esrijan/ddk-hardware/ddk-Back.pdf

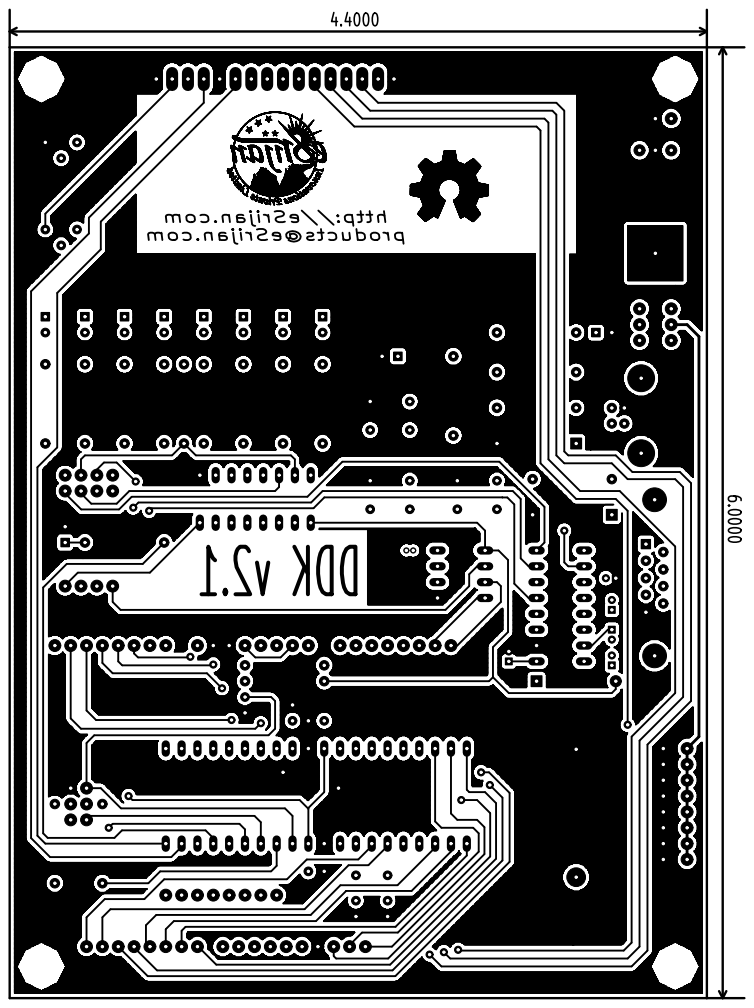
[picture p1: page 1]
