esrijan/ddk-hardware/ddk-drl.pdf

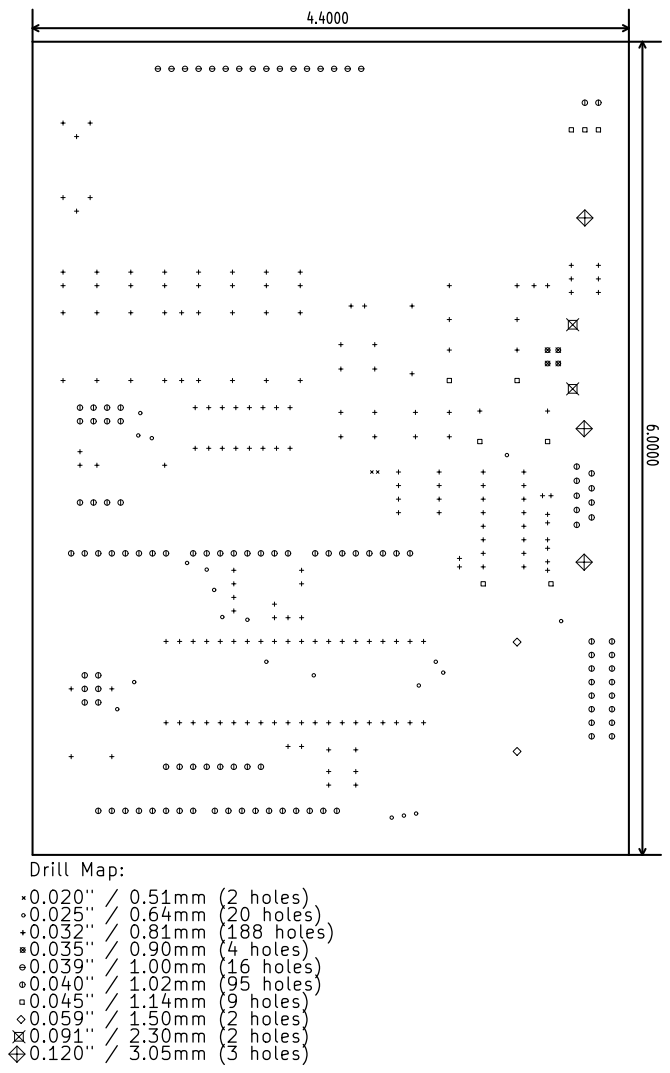
[picture p2: page 1]
