esrijan/ddk-hardware/ddk-Front.pdf

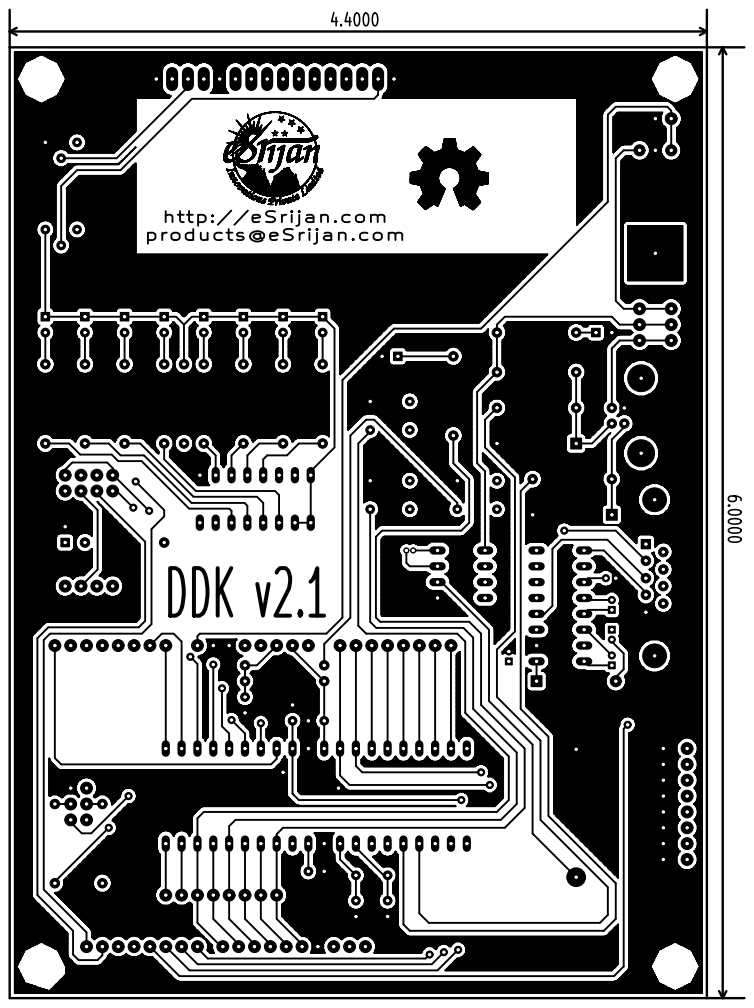
[picture p3: page 1]
