esrijan/ddk-hardware/ddk-Mask_Back.pdf

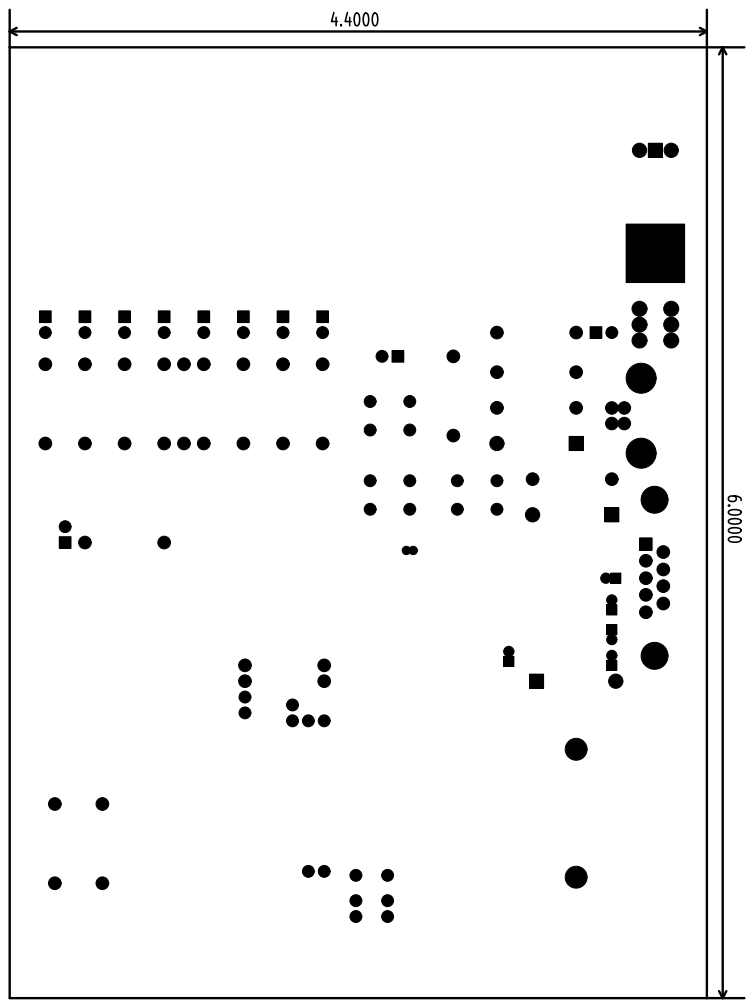
[picture p4: page 1]
