esrijan/ddk-hardware/ddk-Mask_Front.pdf

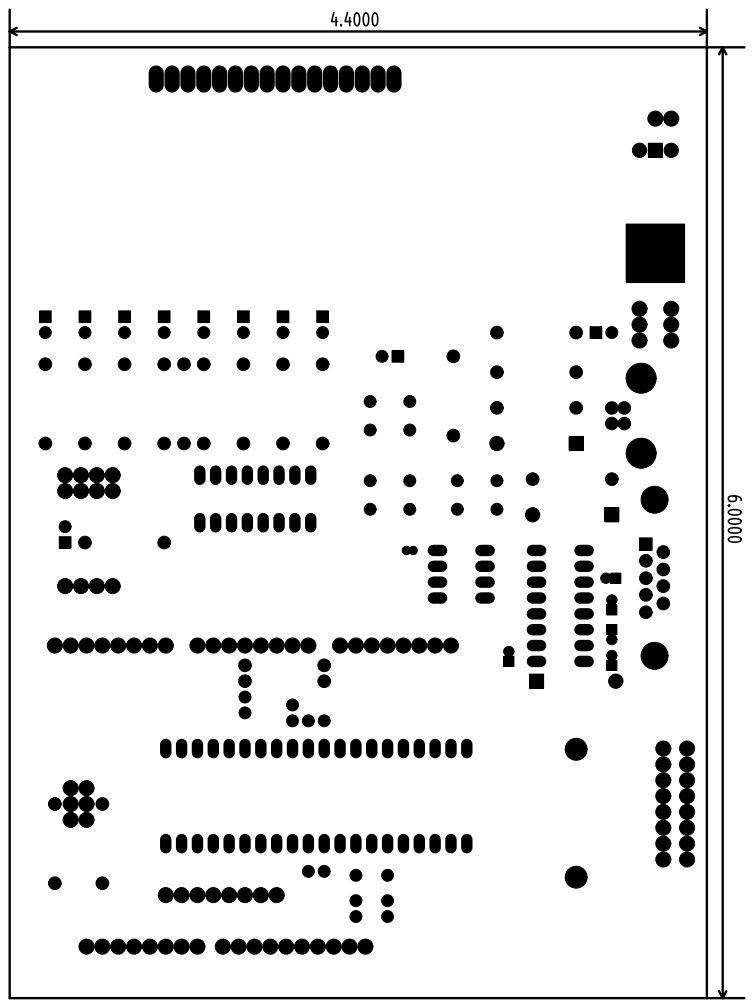
[picture p5: page 1]
