esrijan/ddk-hardware/ddk-SilkS_Back.pdf

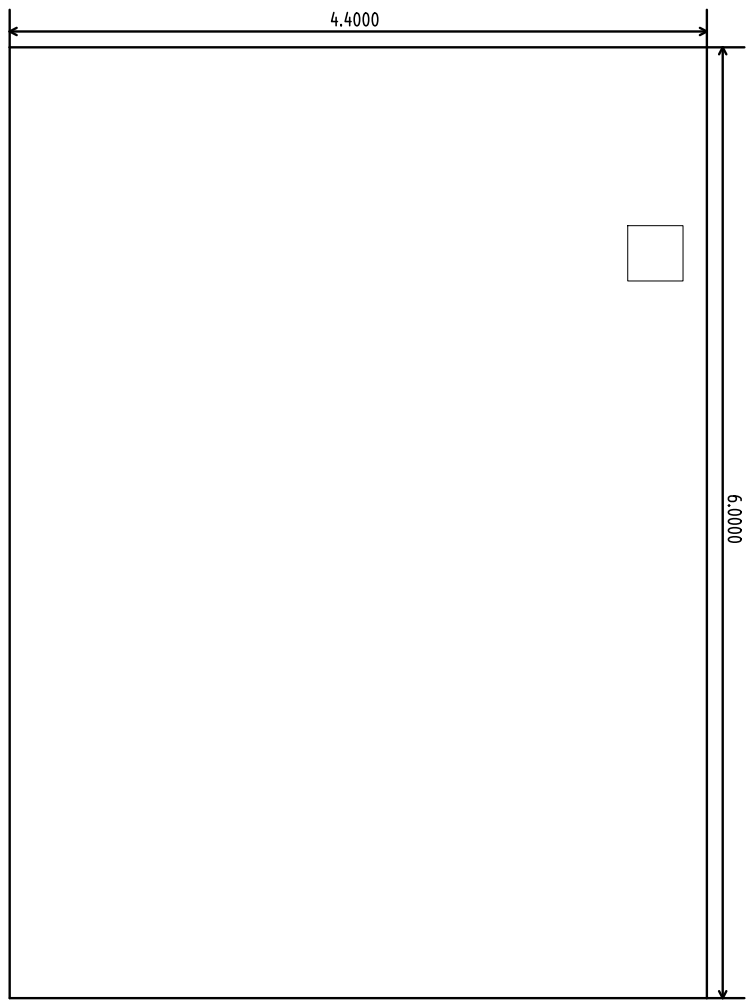
[picture p6: page 1]
