esrijan/ddk-hardware/ddk-SilkS_Front.pdf

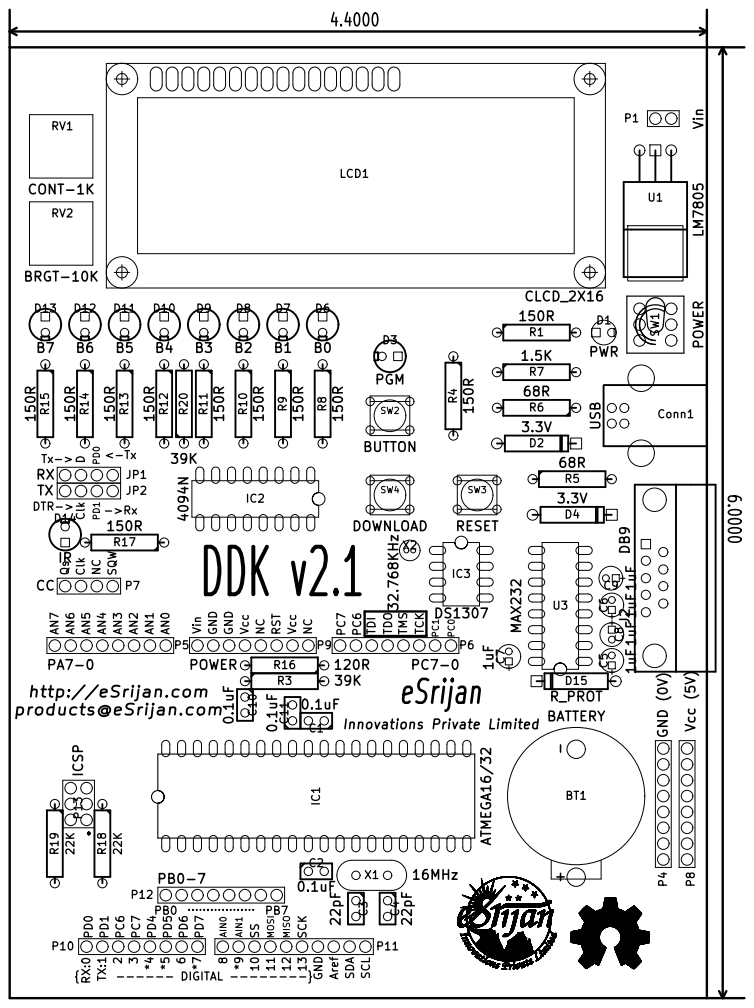
[picture p7: page 1]
