esrijan/ddk-hardware/ddk.sch

## KiCad design ddk.sch (2013-03-20, an earlier design)

Schematic: ddk.sch

Parts:
BT1: BATTERY
C1, C2, C10, C11: 0.1uF; C1
C3, C4: 22pF; C1
C5, C6, C7, C8, C9: 1uF; C1/16
Conn1: USB; CONN_USB-B
D1: PWR; LED3
D2, D4: 3.3V; D5
D3: PGM; LEDV
D6: B0; LEDV
D7: B1; LEDV
D8: B2; LEDV
D9: B3; LEDV
D10: B4; LEDV
D11: B5; LEDV
D12: B6; LEDV
D13: B7; LEDV
D14: IR; LEDV
D15: G_PROT; D5
IC1: ATMEGA16/32; atmel-DIL40
IC2: 4094N; 40xx-DIL16
IC3: DS1307; dallas-SOIC-8
J2: DB9; DB9FC
JP1: RX; header-4
JP2: TX; header-4
LCD1: CLCD 2X16; lcd_2x16_led_backlight-HY-1602F
P1: Vin; header-2
P4: GND (0V); header-8
P5: PA7-0; header-8
P6: PC7-0; header-8
P7: CC
P8: Vcc (5V); header-8
P9: POWER; header-8
P10: DIGITAL; header-8
P11: DIGITAL 2; header-10
P12: PB0-7; header-8
P13: ICSP; header-3x2
R1, R4, R8, R9, R10, R11, R12, R13, R14, R15, R17: 150R; R5
R3: 39K; R5
R5, R6: 68R; R5
R7: 1.5K; R5
R16: 120R; R5
R18, R19: 22K; R5
RV1: CONT-1K; pot_sq
RV2: BRGT-10K; pot_sq
SW1: POWER
SW2: BUTTON; sw_push_s
SW3: RESET; sw_push_s
SW4: DOWNLOAD; sw_push_s
U1: LM7805; LM78XX
U3: MAX232; max232ti-DIL16
X1: 16MHz; Cr2
X2: 32.768KHz; CrClk
