esrijan/ddk-hardware/(commit log)

2012-12-21 Readying the DDK hardware design v1.1 for upload to shareable git.
    [usb_driver_kit.brd, usb_driver_kit.sch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]
2013-02-13 DDK v2.0 related checkin
    + Renamed usb_driver_kit to ddk
    + Corrected the description swap between .cmp & .stf files in the README.md
    + Final schematic (w/ old annotations preserved)
    + Final footprint associations (w/ old annotations preserved)
    + Board layout & related stuff are still the old ones
    [ddk.brd, ddk.sch, usb_driver_kit.sch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]
2013-02-14 DDK v2.0 related checkin #2
    + Final board layout done (for the schematic & footprint associations, already checked-in)
    > Alongwith, placed eSrijan & OSHW's logos as modules in board's copper & silkscreen layers
    > So, adding the corresponding module related files, as well
    + Consequently, plotted the same in .ps format & then converted to .pdf format (using ps2pdf)
    > Front, Back, Mask_Front, Mask_Back, SilkS_Front, SilkS_Back
    > Alongwith generated the drill file as well
    + As the plot file names have changed, deleted the earlier boards' (DDK v1.*) .ps & .pdf files
    [ddk.drl]
2013-02-15 DDK v2.0 related checkin #3
    + Updates in the final board layout before fabrication, as per the inputs from the fabricator
    > All vias' (pad) increased - at least 0.045" as in DDK v1.*
    . Triggered a complete recheck & via-track distance fixes in the board
    > Corrected 3mm LED's pad & drill sizes to same as for the normal 5mm LED (it was too small)
    . Got changes generated through module editor but then manually edited in leds module and ddk.brd
    > Increased the clock crystal's pads size a bit (it was too small & would still remain small)
    . Got changes generated through module editor but then manually edited in crystals module and ddk.brd
    > All headers' drill size to be 1mm
    . Got chang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
    [ddk.csv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]
2013-03-20 DDK v2.1 related checkin #2
    Where is the DDK v2.1 related checkin #1? Actually, the previous one
    commit referred as DDK v2.0 checkin #3, is in fact the DDK v2.1 related
    checkin #1. And this checkin is the final checkin, as sent for
    fabrication of DDK v2.1. It contains the following changes from v2.0:
    + Schematic:
    > Pulled-up the D of shift resister to get fixed default off state
    of the LED array
    > Renamed the G(ermanium) Prot(ection) to R(everse) Protection, as
    the normal diode seems more promising than the germanium diode,
    at least in the forward bias mode
    > Version change to 2.1
    + Layout:
    > Did font size adjustments to make "products@..." clearer
    > Pushed the DB9 connector more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
    [ddk.csv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]
2013-12-09 DDK v2.1 related checkin #3
    Deleted the DDK v1.1's soldering perspective BOM from the DDK v2.x
    design, as we do not need one. ddk.csv is sufficient
